inventowiz/obd-teensy-oled/enclosures/OBD2 screen enclosure.stl

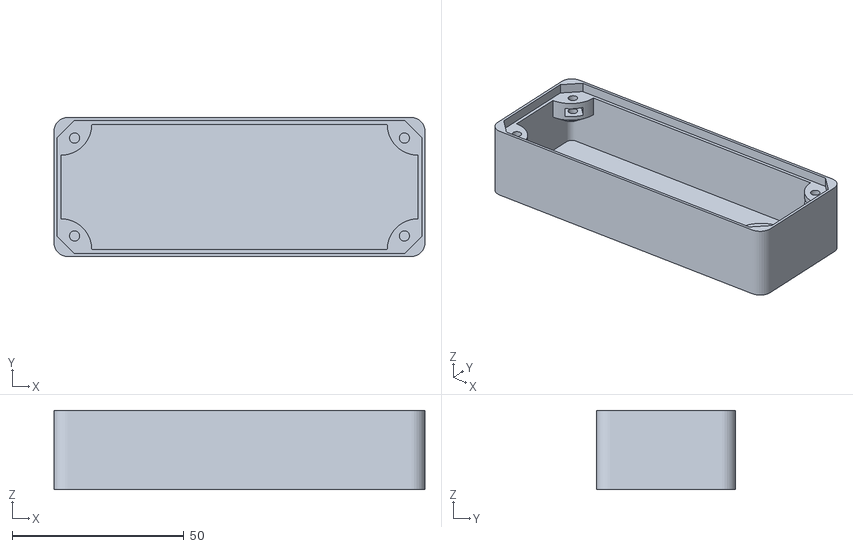
[picture p1: CAD file, 2020-01-22]
enclosures/OBD2 screen enclosure.stl
108.0 x 40.5 x 23.0
