inventowiz/obd-teensy-oled/enclosures/OBD2 dongle enclosure.stl

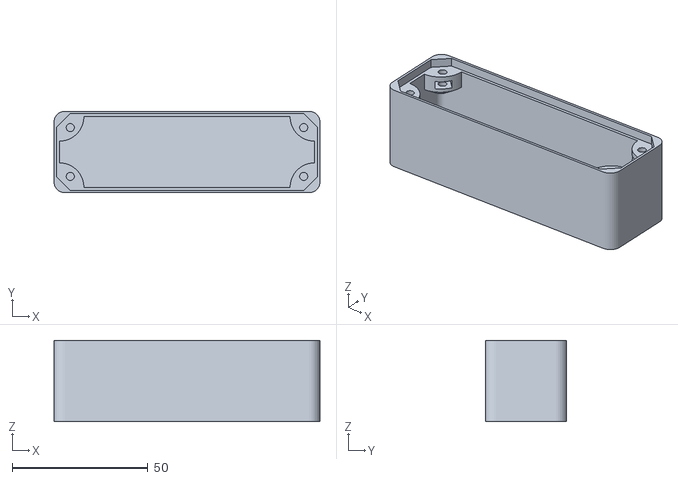
[picture p2: CAD file, 2020-01-22]
enclosures/OBD2 dongle enclosure.stl
98.0 x 30.0 x 30.0
