inventowiz/obd-teensy-oled/enclosures/OBD2 dongle cover.stl

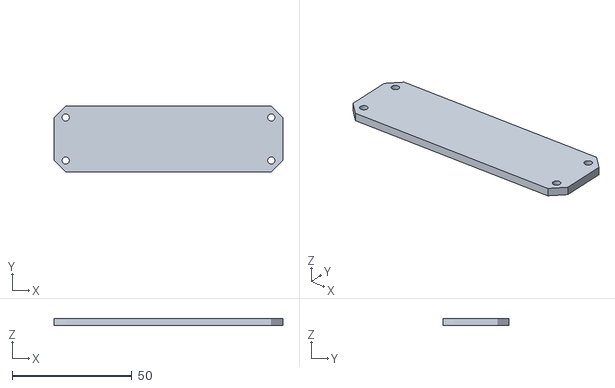
[picture p3: CAD file, 2020-01-22]
enclosures/OBD2 dongle cover.stl
95.8 x 27.8 x 3.00
