inventowiz/obd-teensy-oled/(list of files, cad)

Other CAD files:
enclosures/OBD2 screen enclosure.scad
