inventowiz/obd-teensy-oled/hw/obd-teensy-oled.kicad_pcb

## KiCad design hw/obd-teensy-oled.kicad_pcb (2020-01-10)

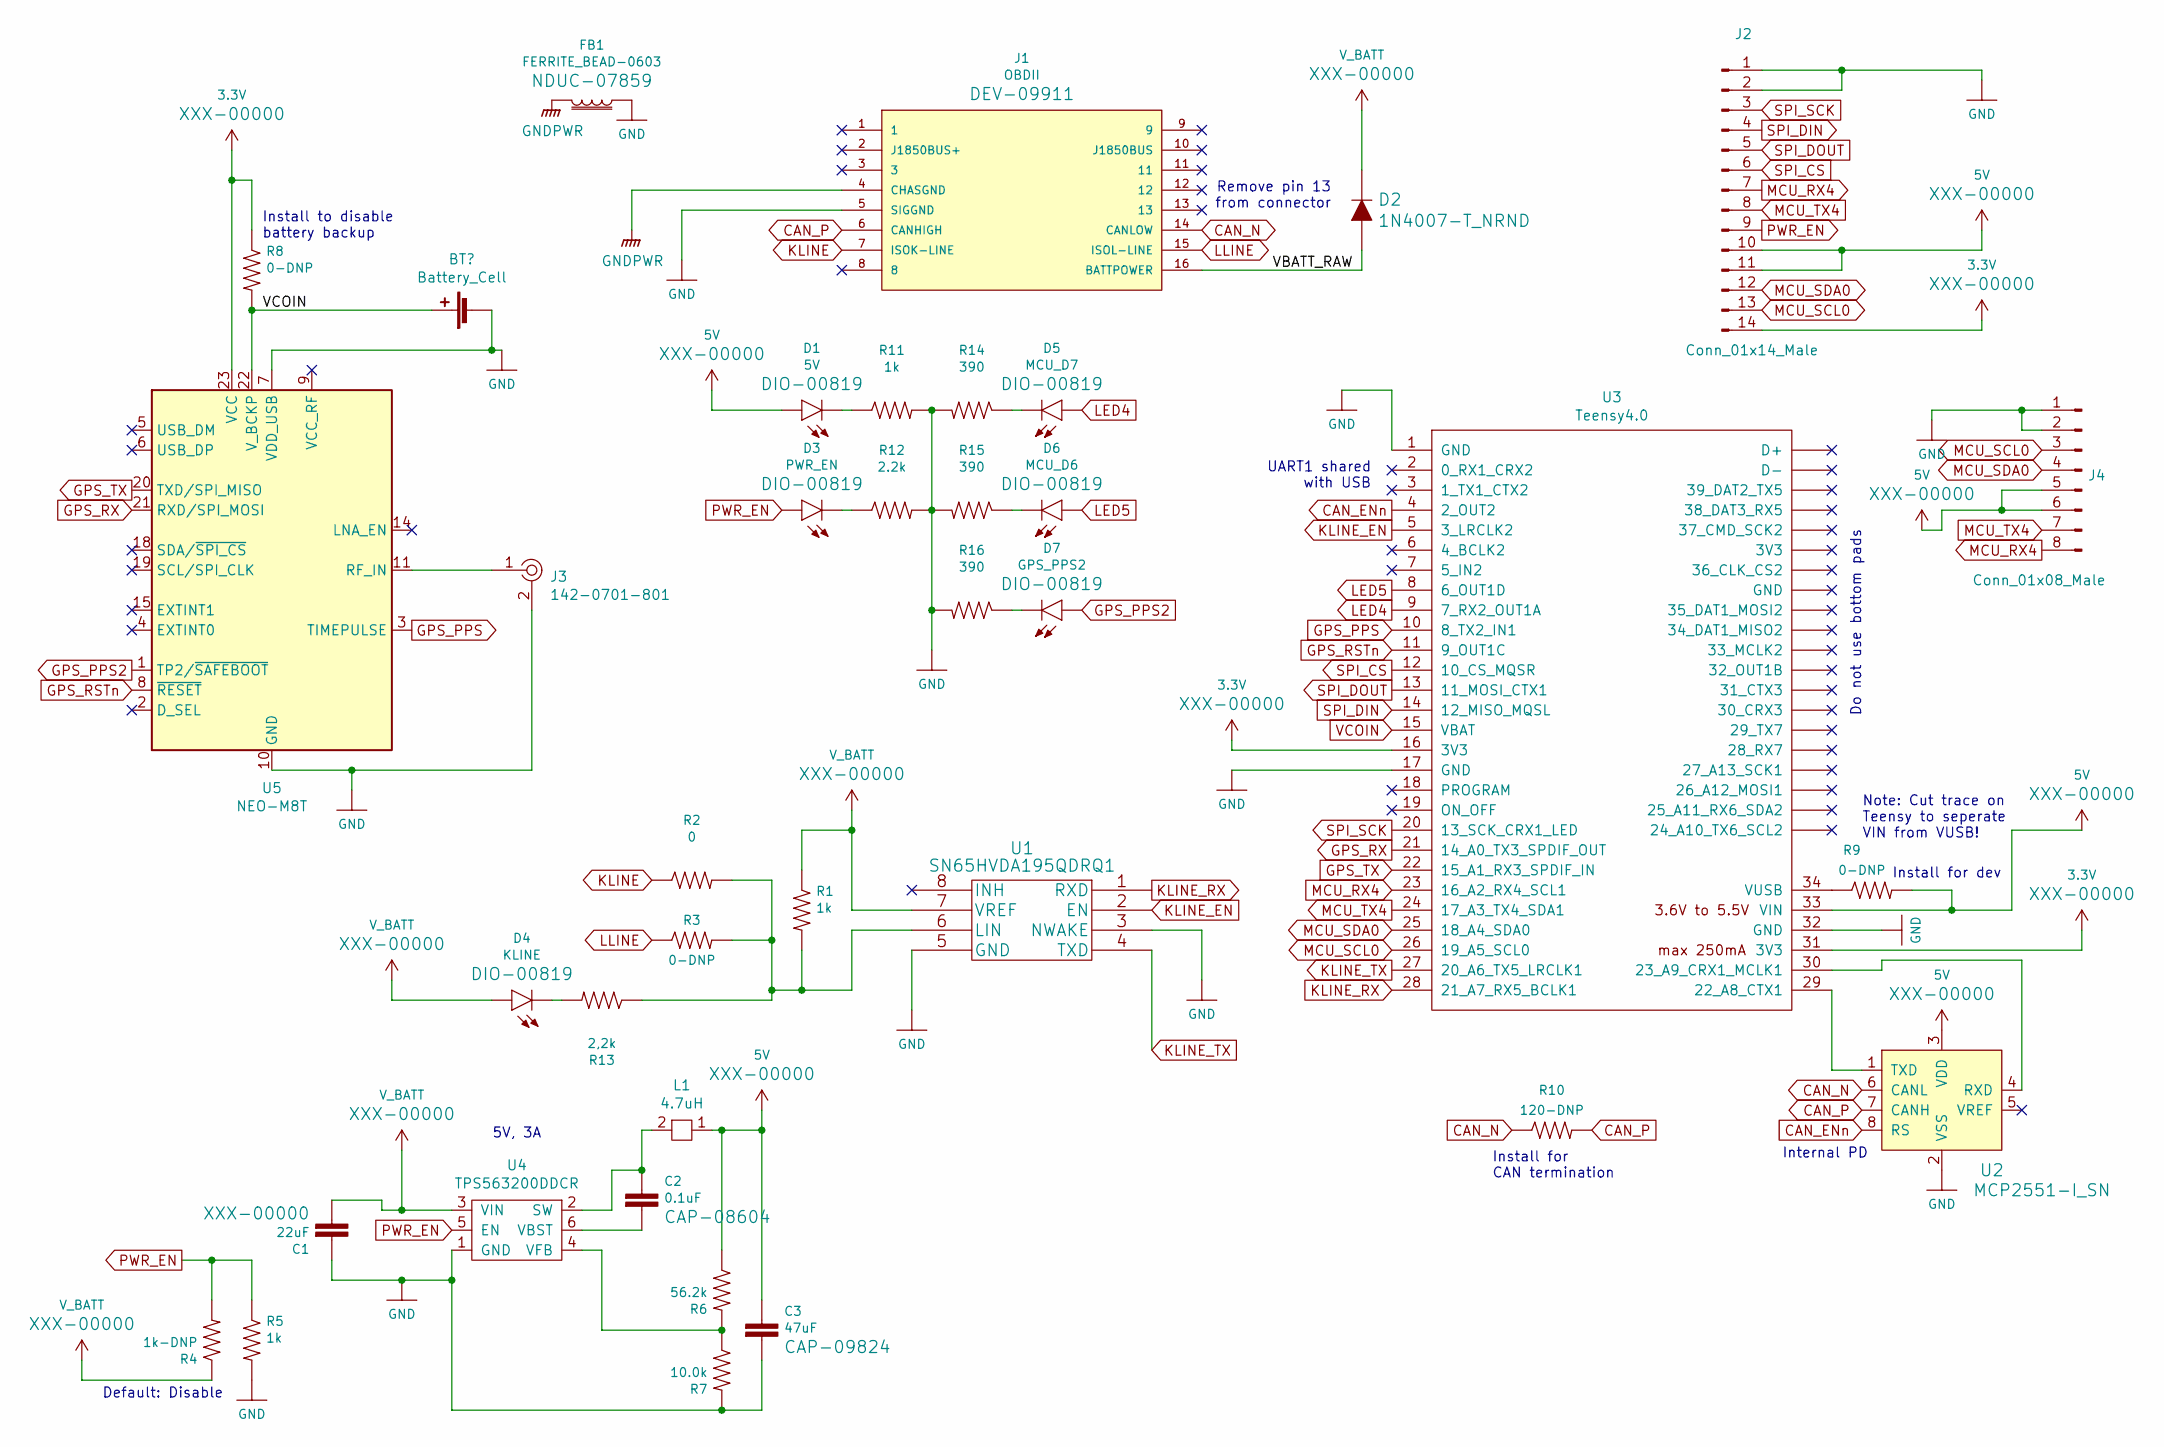
[picture p4: schematic obd-teensy-oled.sch]

Parts:
C1: 22uF; 1210
C2: 0.1uF; 0603
C3: 47uF; 1210
D1: 5V; LED-0603
D2: 1N4007-T_NRND; DO-41; MPN 1N4007-T; Digi-Key_PN 1N4007DICT-ND
D3: PWR_EN; LED-0603
D4: KLINE; LED-0603
D5: MCU_D7; LED-0603
D6: MCU_D6; LED-0603
D7: GPS_PPS2; LED-0603
FB1: FERRITE_BEAD-0603; 0603
J1: OBDII
J2: Conn_01x14_Male; Molex_PicoBlade_53048-1410_1x14_P1.25mm_Horizontal
J3: 142-0701-801; RF_SMA_BoardEdge_142-0701-801; MPN 142-0701-801; Digi-Key_PN J502-ND
J4: Conn_01x08_Male; Molex_PicoBlade_53047-0810_1x08_P1.25mm_Vertical
L1: 4.7uH; IHLP2020BZER4R7M11
R1, R5, R11: 1k; 0603
R2: 0; 0603
R3, R8, R9: 0-DNP; 0603
R4: 1k-DNP; 0603
R6: 56.2k; 0603
R7: 10.0k; 0603
R10: 120-DNP; 0603
R12: 2.2k; 0603
R13: 2,2k; 0603
R14, R15, R16: 390; 0603
U1: SN65HVDA195QDRQ1
U2: MCP2551-I_SN; SOIC-8_W3.9mm; MPN MCP2551-I/SN; Digi-Key_PN MCP2551-I/SN-ND
U3: Teensy4.0; Teensy40
U4: TPS563200DDCR; SOT-23-6
U5: NEO-M8T; ublox_NEO

Connections:
3.3V: J2.14, R8.1, U3.16 (3V3), U3.31 (3V3), U5.23 (VCC)
5V: C3.1, D1.A, J2.10, J2.11, J4.5, J4.6, L1.1, R6.1, R9.2, U2.3 (VDD), U3.33 (VIN)
/VBATT_RAW: D2.A, J1.16 (BATTPOWER)
CAN_ENn: U2.8 (RS), U3.4 (2_OUT2)
CAN_N: J1.14 (CANLOW), R10.1, U2.6 (CANL)
CAN_P: J1.6 (CANHIGH), R10.2, U2.7 (CANH)
GND: C1.2, C3.2, FB1.1, J1.5 (SIGGND), J2.1, J2.2, J3.2, J4.1, J4.2, R5.2, R7.2, R11.2, R12.2, R14.2, R15.2, R16.2, U1.3 (NWAKE), U1.5 (GND), U2.2 (VSS), U3.1 (GND), U3.17 (GND), U3.32 (GND), U4.1 (GND), U5.7 (VDD_USB), U5.10 (GND), U5.12 (GND), U5.13 (GND), U5.24 (GND); also elsewhere on the board
GNDPWR: FB1.2, J1.4 (CHASGND)
GPS_PPS: U3.10 (8_TX2_IN1), U5.3 (TIMEPULSE)
GPS_PPS2: D7.A, U5.1 (TP2/~SAFEBOOT)
GPS_RSTn: U3.11 (9_OUT1C), U5.8 (~RESET)
GPS_RX: U3.21 (14_A0_TX3_SPDIF_OUT), U5.21 (RXD/SPI_MOSI)
GPS_TX: U3.22 (15_A1_RX3_SPDIF_IN), U5.20 (TXD/SPI_MISO)
KLINE: J1.7 (ISOK-LINE), R2.1
KLINE_EN: U1.2 (EN), U3.5 (3_LRCLK2)
KLINE_RX: U1.1 (RXD), U3.28 (21_A7_RX5_BCLK1)
KLINE_TX: U1.4 (TXD), U3.27 (20_A6_TX5_LRCLK1)
LED4: D5.A, U3.9 (7_RX2_OUT1A)
LED5: D6.A, U3.8 (6_OUT1D)
LLINE: J1.15 (ISOL-LINE), R3.1
MCU_RX4: J2.7, J4.8, U3.23 (16_A2_RX4_SCL1)
MCU_SCL0: J2.13, J4.3, U3.26 (19_A5_SCL0)
MCU_SDA0: J2.12, J4.4, U3.25 (18_A4_SDA0)
MCU_TX4: J2.8, J4.7, U3.24 (17_A3_TX4_SDA1)
unnamed: C2.1, L1.2, U4.2 (SW)
unnamed: C2.2, U4.6 (VBST)
unnamed: D1.C, R11.1
unnamed: D3.C, R12.1
unnamed: D4.C, R13.2
unnamed: D5.C, R14.1
unnamed: D6.C, R15.1
unnamed: D7.C, R16.1
unnamed: J3.1, U5.11 (RF_IN)
unnamed: R1.2, R2.2, R3.2, R13.1, U1.6 (LIN)
unnamed: R6.2, R7.1, U4.4 (VFB)
unnamed: R9.1, U3.34 (VUSB)
unnamed: U2.1 (TXD), U3.29 (22_A8_CTX1)
unnamed: U2.4 (RXD), U3.30 (23_A9_CRX1_MCLK1)
PWR_EN: D3.A, J2.9, R4.2, R5.1, U4.5 (EN)
SPI_CS: J2.6, U3.12 (10_CS_MQSR)
SPI_DIN: J2.4, U3.14 (12_MISO_MQSL)
SPI_DOUT: J2.5, U3.13 (11_MOSI_CTX1)
SPI_SCK: J2.3, U3.20 (13_SCK_CRX1_LED)
VCOIN: R8.2, U3.15 (VBAT), U5.22 (V_BCKP); also elsewhere on the board
V_BATT: C1.1, D2.K, D4.A, R1.1, R4.1, U1.7 (VREF), U4.3 (VIN)

Notes on the sheet:
Note: Cut trace on Teensy to seperate VIN from VUSB!
Do not use bottom pads
Default: Disable
Install to disable battery backup
UART1 shared with USB
Install for dev
Install for CAN termination
Remove pin 13 from connector
Internal PD
5V, 3A

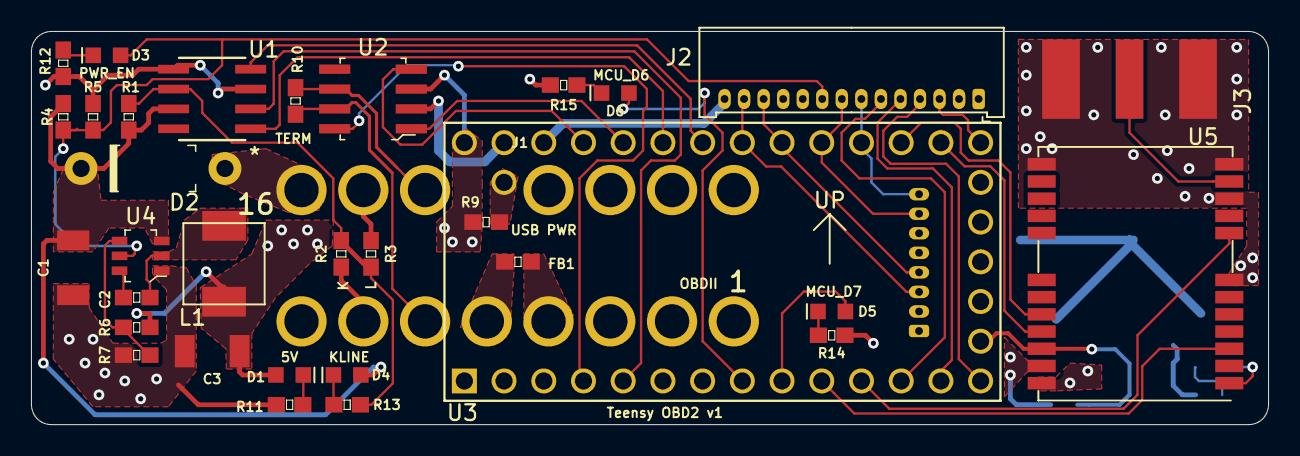
[picture p5: board obd-teensy-oled.kicad_pcb from above]

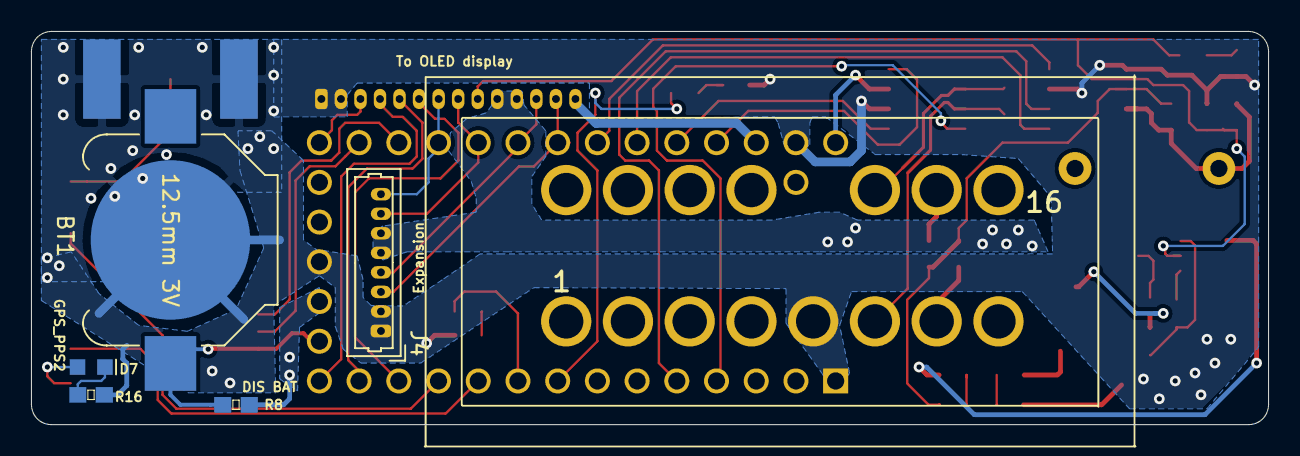
[picture p6: board obd-teensy-oled.kicad_pcb from below]

Board: 2 copper layers, 79.1 x 25.1 mm, 38 parts (5 on the bottom side), 45 nets.

Other parts of the board:
BT1: Battery_Cell; BatteryHolder_Keystone_3000_1x12mm

Their connections:
GND: BT1.2; also elsewhere on the board
VCOIN: BT1.1; also elsewhere on the board
