inventowiz/obd-teensy-oled/(commit log)

2020-01-10 initial commit of hw and fw
    [obd-teensy-oled.csv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]
2020-01-22 add enclosures to the repo
    [OBD2 dongle cover.stl, OBD2 dongle enclosure.scad, OBD2 dongle enclosure.stl, OBD2 screen enclosure.scad, OBD2 screen enclosure.stl]
